jamesarich/p1-car-mount/images/bore-cutaway.png

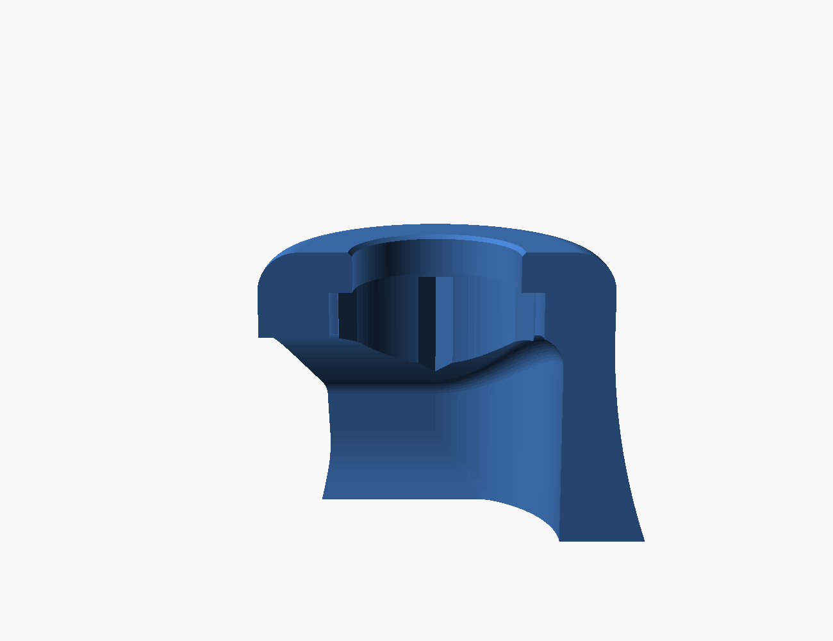
images/bore-cutaway.png
