jamesarich/p1-car-mount/images/front-detail.png

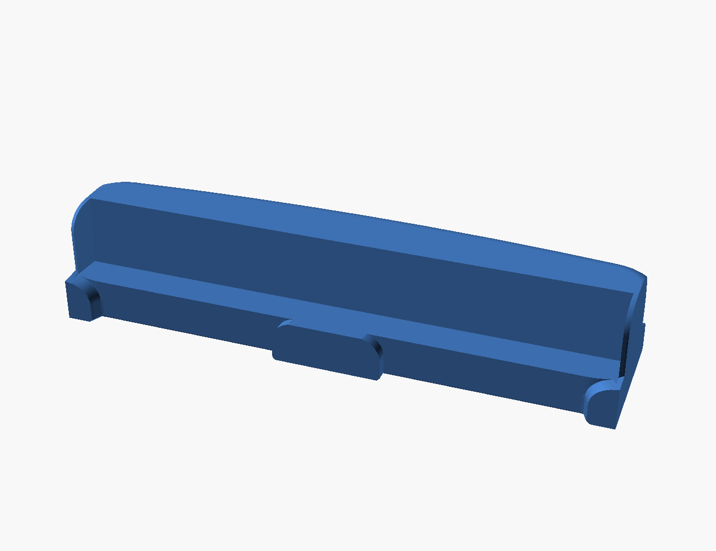
images/front-detail.png
