jamesarich/p1-car-mount/images/pylon-stock.png

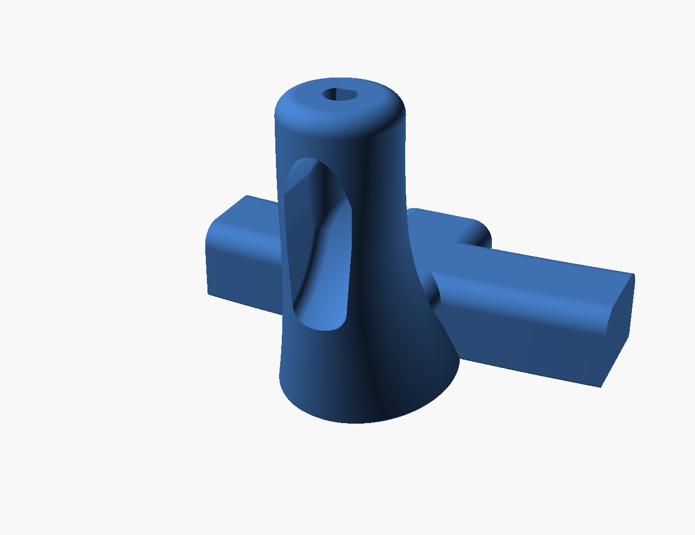
images/pylon-stock.png
