jamesarich/p1-car-mount/images/pylon.png

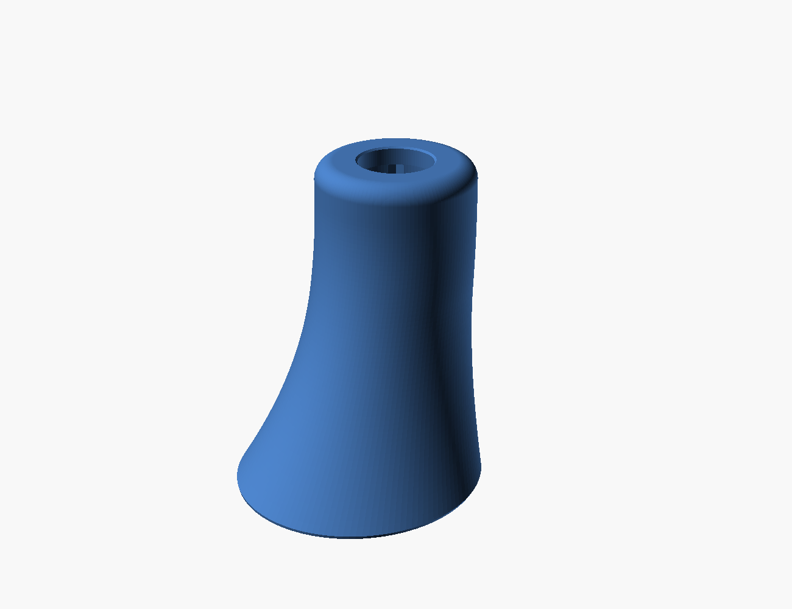
images/pylon.png
