jamesarich/p1-car-mount/images/rear-detail.png

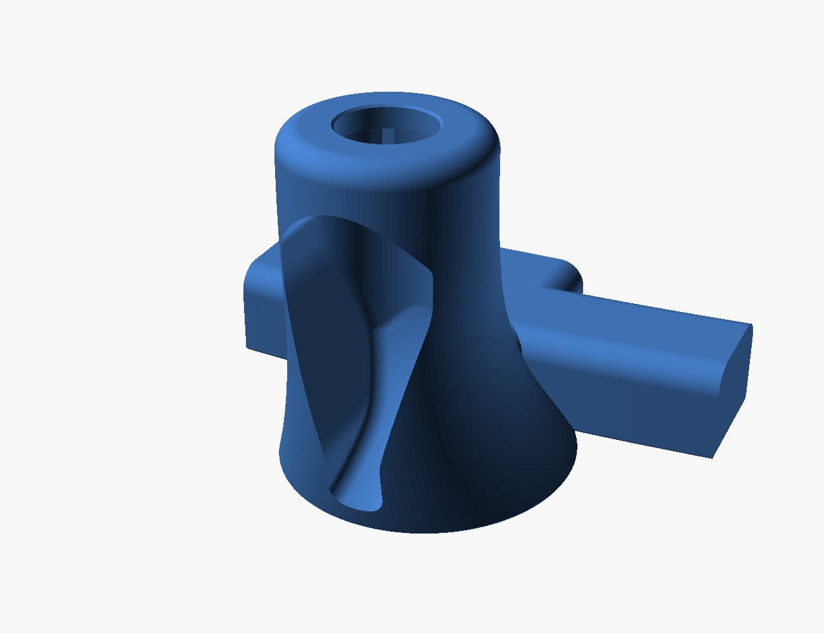
images/rear-detail.png
