jamesarich/p1-car-mount/images/side.png

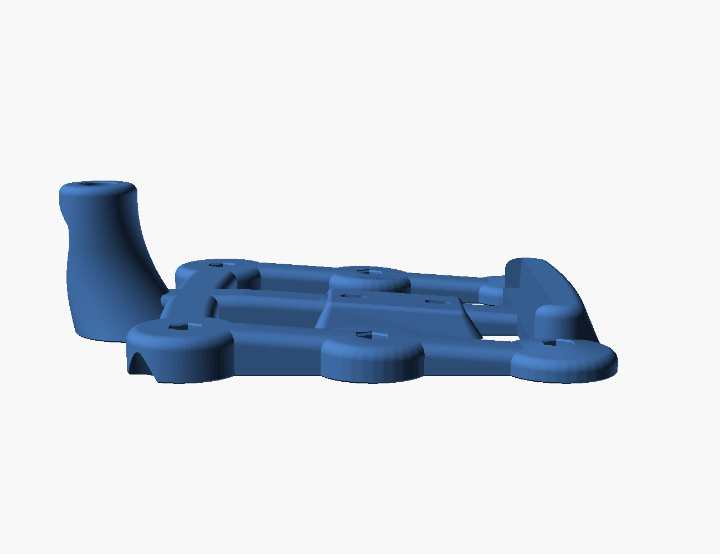
images/side.png
