jamesarich/p1-car-mount/p1-roof-mount-stock.stl

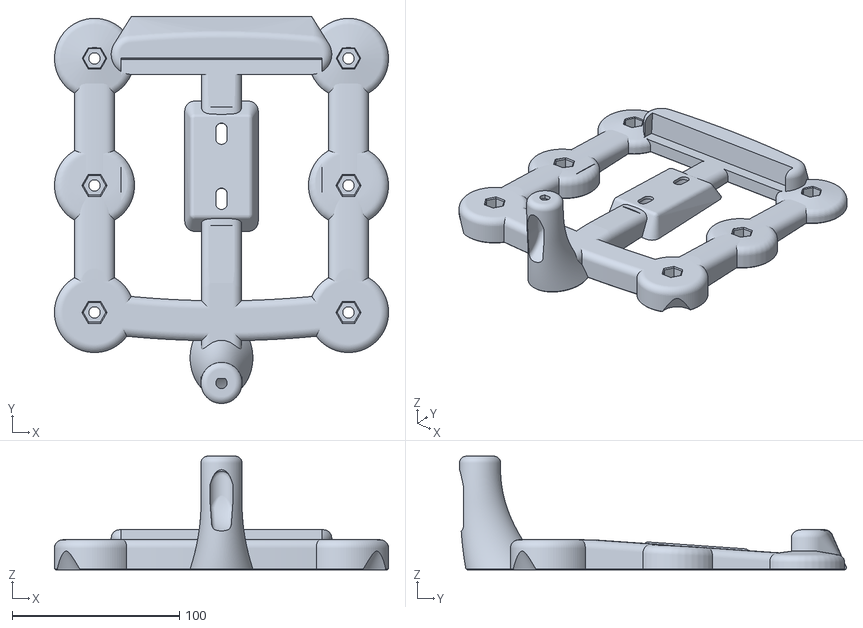
[picture p13: CAD file, 2026-10-28]
p1-roof-mount-stock.stl
200.0 x 231.6 x 68.0
