jamesarich/p1-car-mount/p1-coupon-rear-right-foot.stl

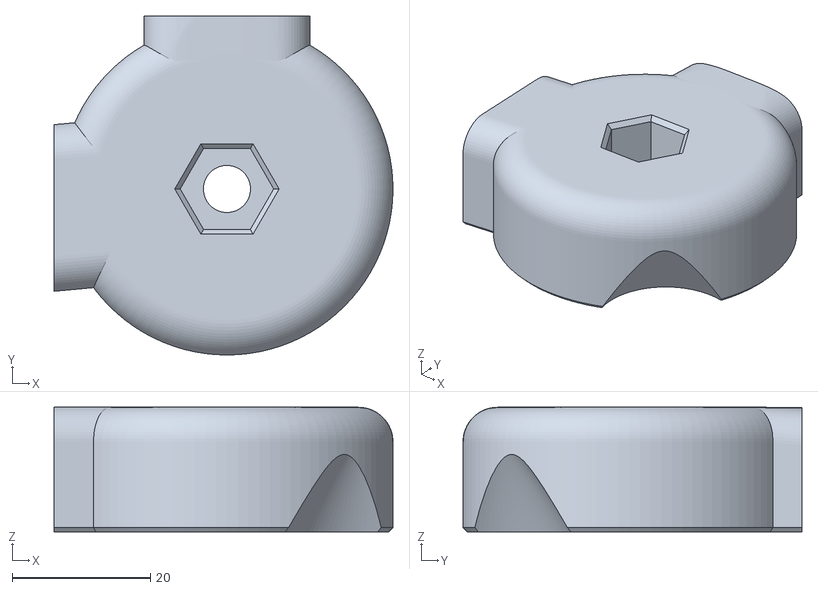
[picture p14: CAD file, 2026-10-28]
p1-coupon-rear-right-foot.stl
49.0 x 49.0 x 18.0
