jamesarich/p1-car-mount/p1-roof-mount-n-type.stl

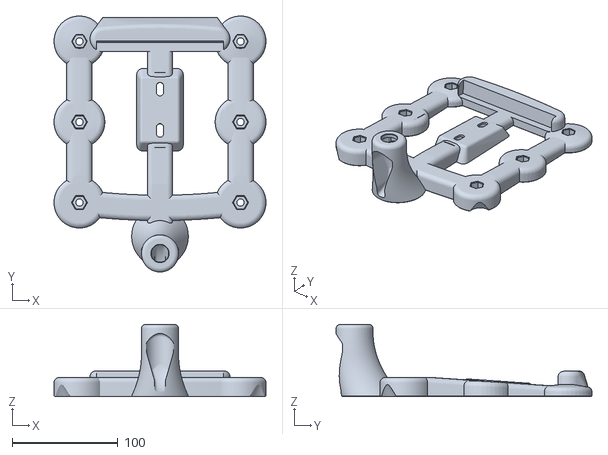
[picture p15: CAD file, 2026-10-28]
p1-roof-mount-n-type.stl
200.0 x 241.5 x 68.0
