jamesarich/p1-car-mount/p1-coupon-pylon.stl

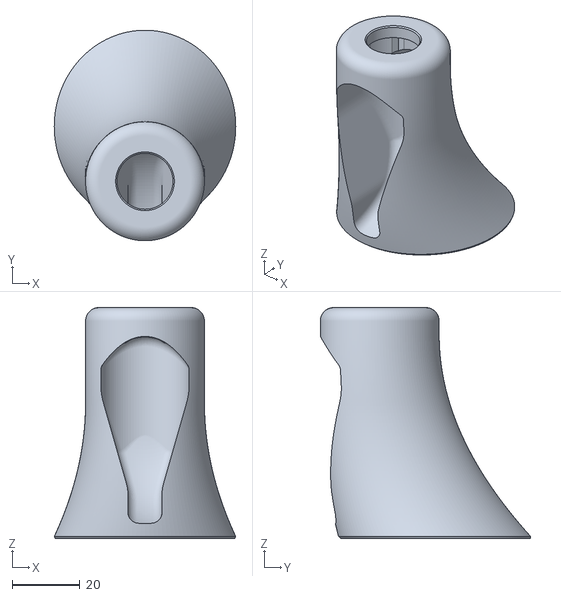
[picture p16: CAD file, 2026-10-28]
p1-coupon-pylon.stl
53.4 x 62.0 x 68.0
