jamesarich/p1-car-mount/p1-coupon-front-foot.stl

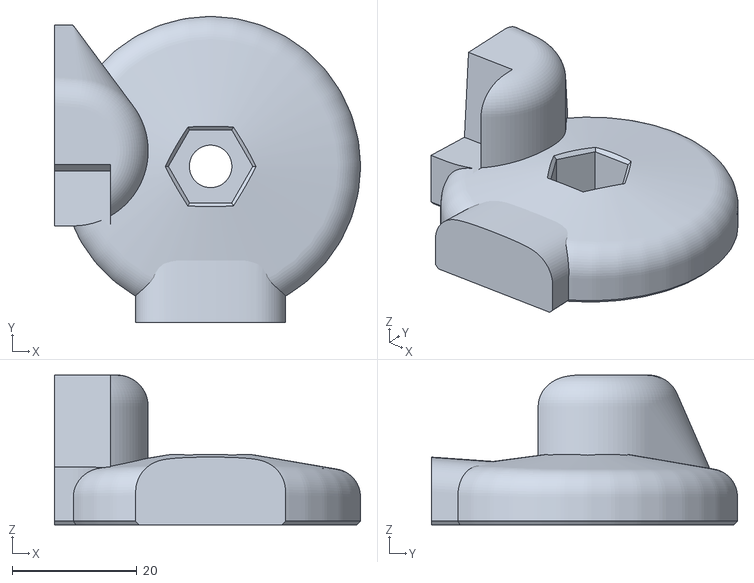
[picture p17: CAD file, 2026-10-28]
p1-coupon-front-foot.stl
49.0 x 49.0 x 24.0
