jamesarich/p1-car-mount/p1-coupon-seat.stl

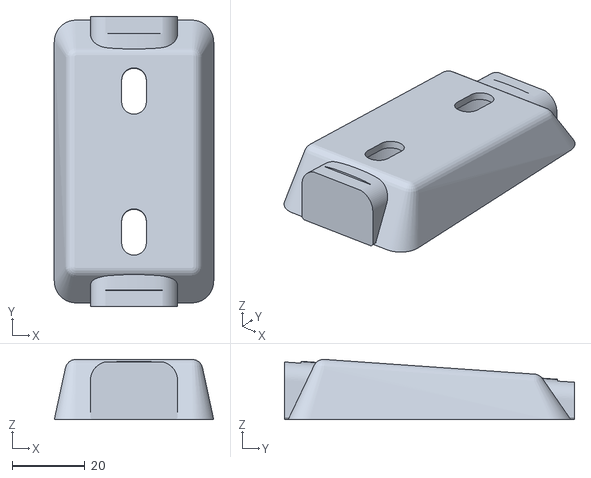
[picture p18: CAD file, 2026-10-28]
p1-coupon-seat.stl
44.0 x 80.0 x 16.7
