jamesarich/p1-car-mount/images/bore-cutaway.scad

$vpt = [-12, -126, 58]; $vpr = [75, 0, 90]; $vpd = 170;
color("#3f72b5") intersection() { import("../p1-roof-mount-n-type.stl"); translate([-25,-150,38]) cube([25,48,40]); }
