jamesarich/p1-car-mount/images/front-detail.scad

$vpt = [0, 84, 12]; $vpr = [60, 0, 20]; $vpd = 300;
color("#3f72b5") intersection() { import("../p1-roof-mount-n-type.stl"); translate([-61,64,0]) cube([122,40,30]); }
