jamesarich/p1-car-mount/images/overall-stock.scad

$vpt = [0, -15, 15]; $vpr = [55, 0, 35]; $vpd = 560;
import("../p1-roof-mount-stock.stl");
