jamesarich/p1-car-mount/images/pylon-stock.scad

$vpt = [0, -115, 30]; $vpr = [62, 0, 25]; $vpd = 270;
color("#3f72b5") intersection() { import("../p1-roof-mount-stock.stl"); translate([-48,-150,-1]) cube([96,90,76]); }
