jamesarich/p1-car-mount/images/pylon.scad

$vpt = [0, 0, 34]; $vpr = [65, 0, 210]; $vpd = 340;
import("../p1-coupon-pylon.stl");
