jamesarich/p1-car-mount/images/side.scad

$vpt = [0, -5, 25]; $vpr = [80, 0, 90]; $vpd = 640;
import("../p1-roof-mount-n-type.stl");
