jamesarich/p1-car-mount/(list of files, cad)

Other CAD files:
p1-coupon-rear-left-foot.stl
images/overall.scad
images/rear-detail.scad
