jamesarich/p1-car-mount/CHANGELOG.md

# Changelog

## 1.0

Initial release: one-piece magnetic roof frame for the SenseCAP Solar Node P1 in N-type and stock-antenna variants, with five fit-test coupons. The stock frame's rear recess and RP-SMA pocket were reworked after the first commit; the N-type frame is unchanged. The stock frame is untested.
