jamesarich/p1-car-mount/(commit log)

2026-10-28 P1 roof mount 1.0
    One-piece magnetic roof frame for the SenseCAP Solar Node P1, in N-type and stock-antenna variants sharing one swept pylon, with five fit-test coupons, OpenSCAD source and build/validation tools. Licensed CC BY-SA 4.0.
    [bore-cutaway.scad, front-detail.scad, overall-stock.scad, overall.scad, p1-coupon-front-foot.stl, p1-coupon-pylon.stl, p1-coupon-rear-left-foot.stl, p1-coupon-rear-right-foot.stl]
2026-10-28 Give the stock pylon the shared rear recess
    The stock chamber could not hold the RP-SMA nut on the bore axis and blocked the cable path, and the node-end plug is wider than the bore. Stock now uses the N-type rear recess with a round pocket for the front-mount jack's hex body under the D-flat roof, nut and lock washer on top, and its own cable, hardware and body-entry checks. Stock RP-SMA dimensions are provisional from Amphenol and Wurth drawings.
    [p1-coupon-front-foot.stl, p1-coupon-pylon.stl, p1-coupon-rear-left-foot.stl, p1-coupon-rear-right-foot.stl, p1-roof-mount-n-type.stl, p1-roof-mount-stock.stl, p1-roof-mount.scad]
2026-10-28 Record the N-type build and the stock pigtail layout
    The printed N-type pylon works. The Seeed stock pigtail is a front-mount jack with its toothed lock washer on the body under the panel, so the docs list what to measure before printing the stock frame.
2026-10-28 Fit the stock pocket to the photo-measured RP-SMA pigtail
    Both washers sit under the roof with the hex body; only the nut goes on top.
    Stock dimensions come from a photo scaled by a US quarter and the 1/4-36 pitch.
    [p1-coupon-pylon.stl, p1-coupon-rear-left-foot.stl, p1-coupon-rear-right-foot.stl, p1-roof-mount-n-type.stl, p1-roof-mount-stock.stl, p1-roof-mount.scad]
2026-10-28 Add a bill of materials with part links
2026-10-28 Note the washers the node screws need
2026-11-03 Add warning, affiliation note and GPLv3 tools license
    The README leads with the magnet-mount risks. Docs now say the N-type frame was printed and the stock frame is untested. Changelog notes the stock rework after the first commit.
2026-11-03 Tighten the tested claim and two print-notes lines
    "Fits and assembles" says what the N-type print showed without implying road testing.
2026-11-03 Add photos of the built N-type frame to the README
    A side photo leads the README and three more sit below the warning. The renders move below them. EXIF is stripped.
